likt0r/water-filter-control/(commit log)

2026-07-03 Initiale Wasserfilter-Ozonsteuerung für ESP32
    Firmware für AZ-Delivery ESP32 WROOM-32: Wasserfluss-Sensor (G3/4"
    Hall, 396 Impulse/L) schaltet über ein SRD-05VDC-SL-C Relais einen
    Ozongenerator, solange Wasser fließt.
    - Impulszählung per ISR, geglättete Durchflussrate (flow)
    - Stromausfallsichere Litersumme im NVS via Preferences (persistence)
    - Relais low-aktiv, boot-sicher AUS; LEDs blau/grün/rot (relay_led)
    - SoftAP-Hotspot mit Statusseite + Zähler-Reset (webserver)
    - PlatformIO-Setup + Zed-Tasks für Build/Upload/Monitor
    [config.h, flow.cpp, flow.h, main.cpp, persistence.cpp, persistence.h, relay_led.cpp]
2026-07-03 Wokwi-Simulation hinzufügen
    Ermöglicht Testen ohne Hardware: Relais-/LED-Logik, Zähler/Persistenz
    und SoftAP-Webseite. Ein Custom-Chip simuliert den Flow-Sensor mit
    F = 6,6 * Q (Regler in L/min).
    - diagram.json: ESP32 + Relaismodul + 3 LEDs + Vorwiderstände + Flow-Chip
    - wokwi.toml: verweist auf PlatformIO-Firmware und den Custom-Chip
    - chips/flow-pulse.chip.c/.json: Pulse-Generator + Makefile
    - WOKWI.md: Anleitung für Web-IDE (ohne lokalen Compiler) und wokwi-cli
2026-07-03 Wokwi: Diagramm-Pins korrigieren, Chip freestanding bauen
    - diagram.json: ESP32-devkit-c-v4 benennt GPIOs als bloße Nummern
    (26/27/25/33/32) und Serial als TX/RX, nicht D../TX0 — korrigiert.
    Alle 16 Verbindungen gegen die echten Pin-Listen validiert.
    - flow-pulse.chip.c: statischer Zustand statt malloc (kein libc nötig)
    - Makefile: freestanding-Build (--target=wasm32 -nostdlib), erzeugt
    gültige WASM mit exportiertem chip_init
2026-07-03 README mit Verkabelungsdiagramm hinzufügen
    Übersicht, Hardware-Liste, ASCII-Verdrahtungsdiagramm + Pin-Tabelle,
    Sicherheitshinweise (220 V, Spannungsteiler), Build-/Flash- und
    Bedienungsanleitung sowie Verweis auf die Wokwi-Simulation.
2026-07-03 LEDs direkt am GPIO: Vorwiderstände an reale Flussspannungen anpassen
    Rot (U_f ≈ 2,1 V): 120 Ω → ~10 mA. Blau/Grün (U_f ≈ 3,0–3,2 V @ 20 mA):
    100 Ω → ~3–6 mA, da U_f bei kleinen Strömen unter 3 V sinkt — als
    Statusanzeige gut sichtbar, Aufbau deutlich einfacher als mit
    Transistorstufe. BC547-Variante (volle Helligkeit an 5 V) bleibt als
    Hinweis im Diagramm dokumentiert. Wokwi-Diagramm angeglichen.
2026-07-03 LED-Selbsttest beim Start auf 2 s verlängern
    Alle drei LEDs leuchten beim Boot 2 Sekunden zur Funktionskontrolle.
    Dauer als LED_SELFTEST_MS in config.h konfigurierbar.
2026-07-03 Rauschfilter für Flow-Erkennung: Mindest-Impulsrate + Pulldown
    Offene/gestörte Sensorleitung erzeugte Phantomimpulse (~0,4 Hz), die
    den Zähler hochzählten und das Relais dauerhaft einschalteten. Fixes:
    - GPIO27 mit INPUT_PULLDOWN statt INPUT
    - Fluss gilt erst ab FLOW_START_MIN_PULSES (4) Impulsen im gleitenden
    1-s-Fenster (~0,6 L/min); echter Fluss liefert >= 6,6 Hz
    - Volumen wird nur bei erkanntem Fluss aufaddiert; Impulse der
    Anlaufsekunde werden beim Flussbeginn nachgeholt
    - Durchflussrate aus dem 1-s-Fenster statt Einzelintervall (glatter)
    Am Board verifiziert: 40 s ohne Phantomfluss (vorher ~0,4 Impulse/s).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
    [config.h, flow.cpp]
2026-07-03 Internen Pulldown am Sensor-Pin entfernen (drückte Teiler unter Schwelle)
    Der interne Pulldown (~45k) lag parallel zum unteren Teilerwiderstand
    und senkte den HIGH-Pegel bei einem 16k/22k-Teiler von 2,89 V auf
    ~2,4 V — unter die garantierte V_IH-Schwelle (2,475 V), wodurch keine
    Impulse mehr erkannt wurden. Störimpulse auf offener Leitung filtert
    bereits der Software-Rauschfilter (FLOW_START_MIN_PULSES).
    Am Board mit realem Sensor verifiziert: Fluss wird erkannt, Relais
    schaltet, Zähler läuft.
2026-07-03 Relais-Polarität auf active-HIGH korrigieren
    Das vorliegende SRD-05VDC-SL-C-Modul reagiert High-aktiv (IN HIGH =
    Relais/Ozon EIN), nicht Low-aktiv. Vorher lief der Ozongenerator
    invertiert — dauerhaft an außer bei Durchfluss. Am Board verifiziert:
    Relais AUS im Ruhezustand, EIN bei Durchfluss.
    [config.h]
2026-07-03 Blaue LED: Helligkeit spiegelt den Durchfluss (PWM)
    Die blaue LED wird per LEDC-PWM gedimmt statt nur an/aus: wenig
    Durchfluss = schwach, ab FLOW_LED_MAX_LPM (15 L/min) volle Helligkeit.
    Gamma ~2 für gefühlt lineare Helligkeit, Mindesthelligkeit als Floor,
    damit auch geringer Fluss sichtbar ist. Am Board verifiziert.
    setFlowLed(bool) -> setFlowLevel(bool flowing, float lpm).
2026-07-03 Leck-Warnschwelle der roten LED auf 60 min erhöhen
    Wasser kann im Normalbetrieb länger als 30 min laufen; erst nach
    60 min Dauerfluss warnt die rote LED vor möglichem Leck/hängendem Sensor.
2026-07-07 CAD: Snap-in-Halter für USB-Netzteilmodul + Gehäuse
    - psu_holder_v1.scad: druckbarer Halter für das AC-DC-USB-Netzteil
    (Platine 31x37x1mm, USB mittig an der langen Wand). Platine wird per
    zwei Schnapp-Fingern eingeklickt; Auflage 3mm hält die 2,3-mm-
    Unterseitenbauteile frei. 4 Befestigungslöcher ausserhalb der Platine
    (48x20mm) -> Clip testen, dann festschrauben.
    - ultimatewaterproofcase_v74.scad: DeviceHolder-Satz 3 aktiviert und auf
    den Halter abgestimmt (48x20mm), kollisionsfrei zu ESP32/Relais.
    [psu_holder_v1.scad, ultimatewaterproofcase_v74.scad]
2026-07-07 Halter: Passung, freifedernde Clips und Power-Aussparung
    - fit_tol 0.4 -> 0.9mm (0,45mm/Seite) + Eckenfreistiche Ø2,5mm gegen
    FDM-Innenradius -> Platine lässt sich einlegen.
    - Schnapp-Finger vom Auflage-Absatz entkoppelt (Absatz an den Fingern
    ausgespart) + finger_th 2.0->1.2, finger_gap 1.0->1.5, hook_over
    1.2->0.8 -> Finger federn jetzt beim Einklicken.
    - Zusätzliche Aussparung für den Power-/AC-Anschluss auf der langen
    Wand gegenüber USB (links bis Mitte), parametrisch.
    [psu_holder_v1.scad]
2026-07-07 Halter: Schnapp-Finger rasten jetzt richtig ein
    - fit_tol 0.9 -> 0.5 (weniger Spiel, damit die Nase nicht durch das
    Spiel "verschluckt" wird)
    - hook_over 0.8 -> 1.1, hook_h 1.5 -> 1.8 -> Griff nominal ~0,85mm
    (worst case 0,6mm) statt 0,35mm
    - finger_th 1.2 -> 1.0 und Wurzel-Freistich in der Platte: Finger federn
    ab ~z=1 statt z=3 (Einspannlänge 7,8 statt 4mm) -> halten den größeren
    Federweg aus (Dehnung ~2,1% statt ~8%)
    [psu_holder_v1.scad]
